LurLab-UCI/ShockBox/Docs/ShockBox_wiring.png

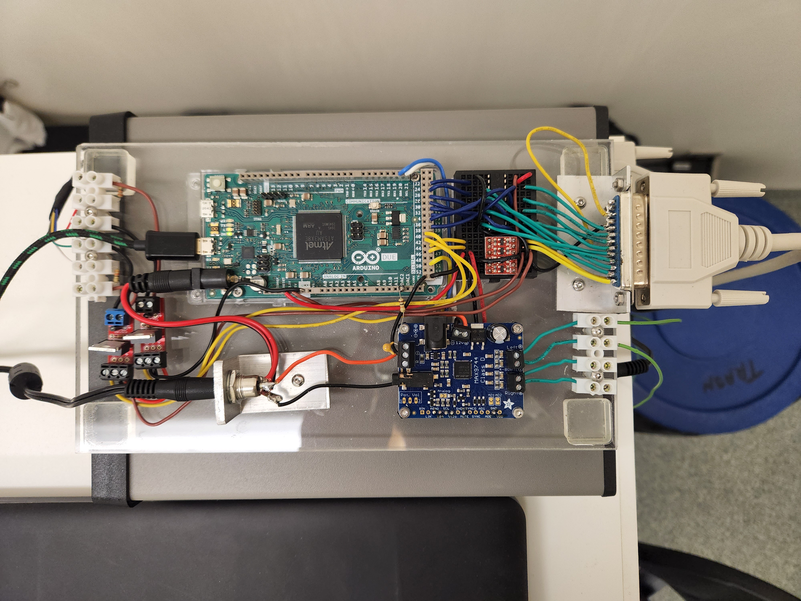
Docs/ShockBox_wiring.png
