LurLab-UCI/ShockBox/Docs/ShockBox_panel+shocker.jpg

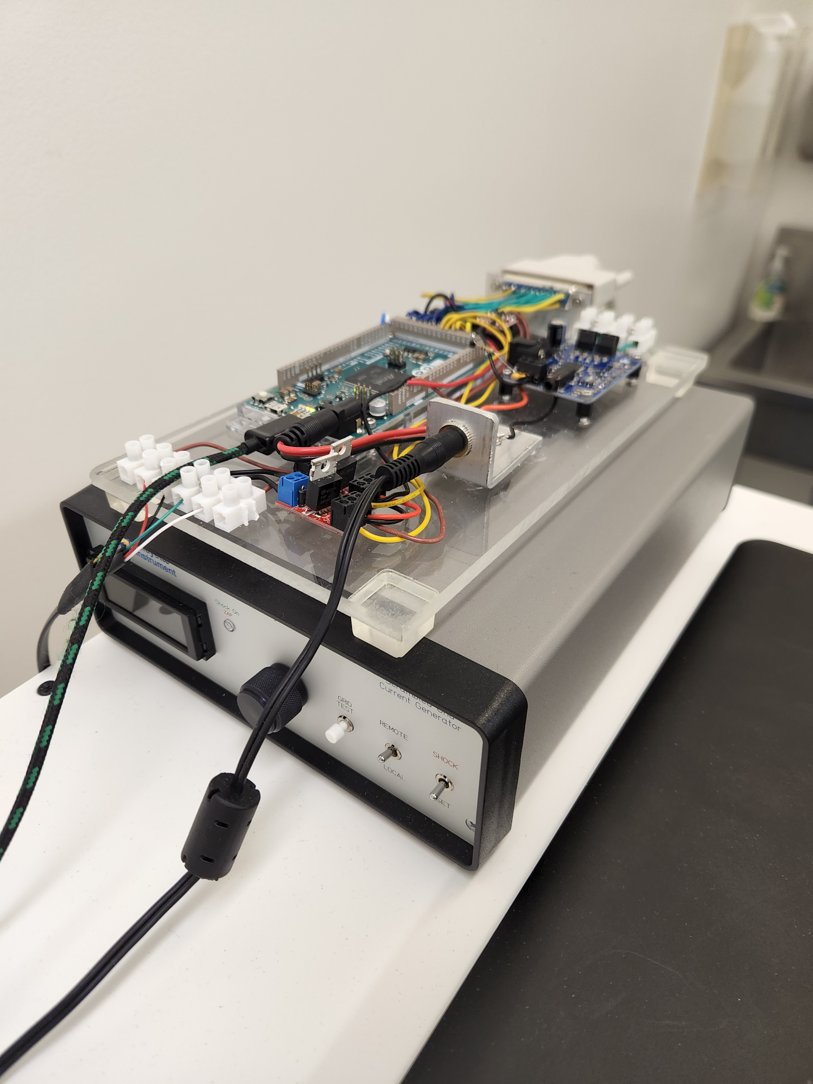
Docs/ShockBox_panel+shocker.jpg
