LurLab-UCI/ShockBox/README.md

# ShockBox

This is a hardware & software package for electric shock generation. It uses some OEM and some off the shelf parts. Experiemtns are run via a GUI developed as open source MATLAB code. 

See wiki page for build and operation details (https://github.com/LurLab-UCI/ShockBox/wiki).

Created by Mikko Oijala, Soo Bin Park, and Gyorgy Lur, PhD; Neuronal Signal Integration laboratory, UC Irvine;

This work was supported by the NIH - R01 MH123686
