LurLab-UCI/ShockBox/Docs/Shock_Box_circuit updated.pptx

Lur Lab Shock Box Circuit

12 V power
supply

+5 V

2

LS-241

19

DB-25 connector

1 Trigger

14 Test In

USB

+5 V

Arduino DUE

40 shock indicator

42 tone indicator

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
LED emitter

330

330

MOSFET Relay

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
LED emitter

MOSFET Relay

+

C

+

+5 V

+5 V

DAC0

SCL

SDA

47

45

Level Converter
BOB-12009

10 k

+12 V

21

20

+3.3 V

Audio Amp MAX 9744

SCL

SDA

Vi2c

Left Speaker

680 pF

Right Speaker

## Slide 2

Lur Lab Shock Box GUI

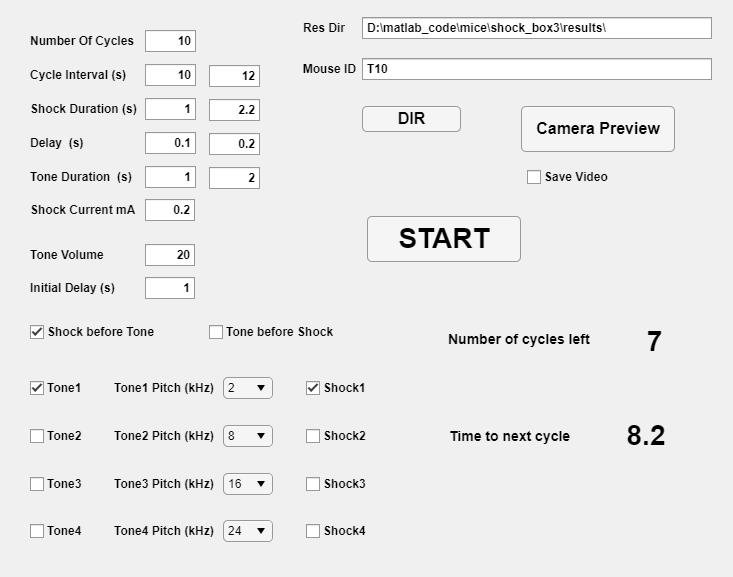
[picture p3: figure]

Each cycle consists of a tone followed or preceded by an optional shock , i.e. a cycle can contain a tone only, but a cycle with a shock is always accompanied with a tone either before or after.
There are 4 possible tones available with an optional shock associated with it.
If more than one tone is selected the tones and the corresponding shocks are played in random order the same number of times (the total number of cycles is adjusted accordingly).

Res Dir
Mouse ID
Camera Preview
Save Video
DIR
START

Number Of Cycles
Cycle Interval
Shock Duration
Delay
Tone Duration
Shock Current
Tone Volume
Initial Delay
Shock before Tone
Tone before Shock

Tone 1 2 3 4
Tone 1 2 3 4 Pitch
Shock 1 2 3 4

Displays the result directory
Input the mouse id here
Turn on the camera and preview
Save the video file of the session in the result directory
Select the result directory
Start the session
Total number of shock cycles in the session
Time from the start of a cycle the start of the next cycle
Duration of each shock
Delay from tone to shock or shock to tone for each cycle
Duration of each tone
The amount of shock current
The audio volume for tones
At the start the system waits this amount before proceeding
When selected each cycle is started with a shock followed by a tone
When selected each cycle is started with a tone followed by a shock

Select the tones used
Select the frequencies for the tones used
Select whether a shock is used with the tone
