LurLab-UCI/ShockBox/Docs/Shock_Box_circuit updated.png

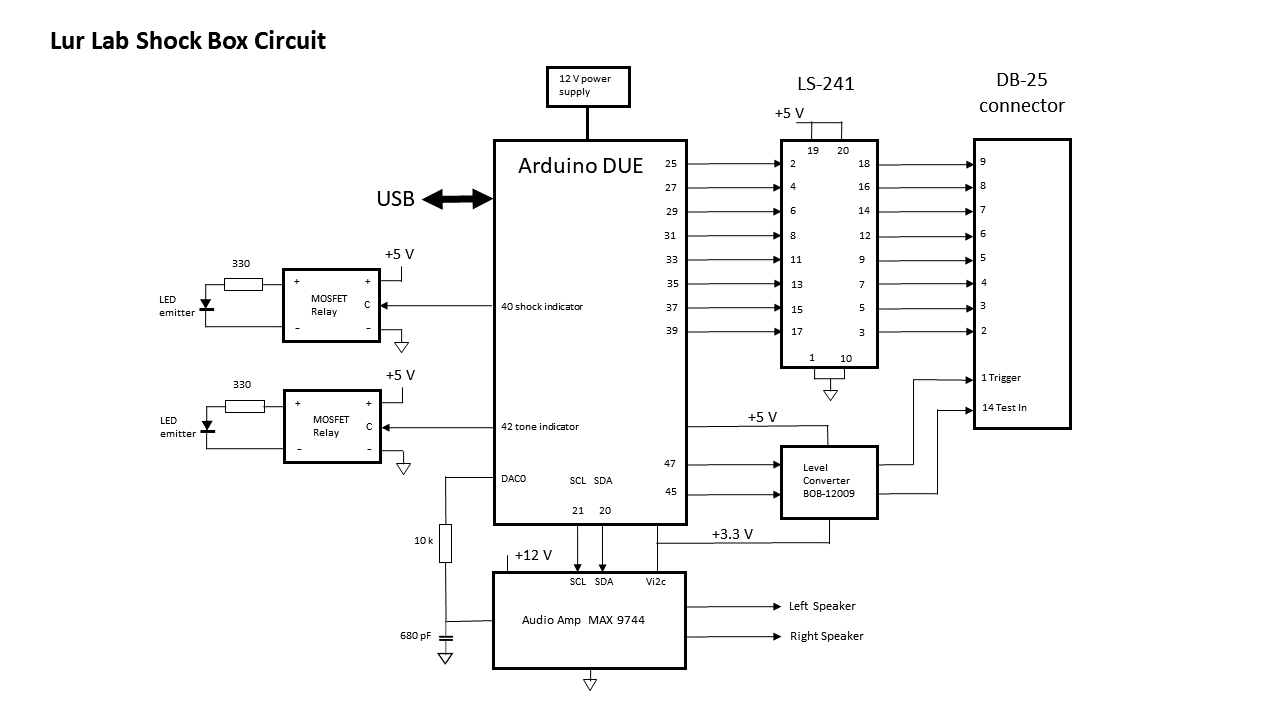
Docs/Shock_Box_circuit updated.png
