LurLab-UCI/ShockBox/Docs/Shock_Box_GUI.png

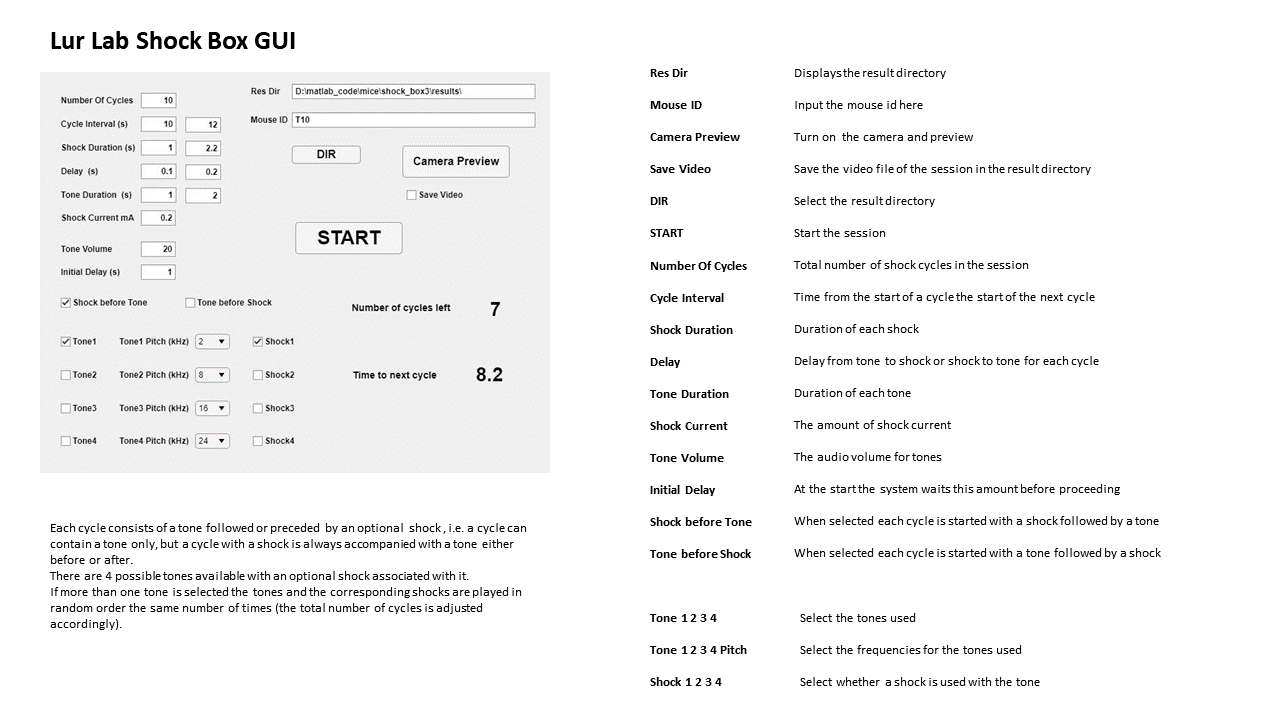
Docs/Shock_Box_GUI.png
