LurLab-UCI/ShockBox/Docs/ShockBox_camera.jpg

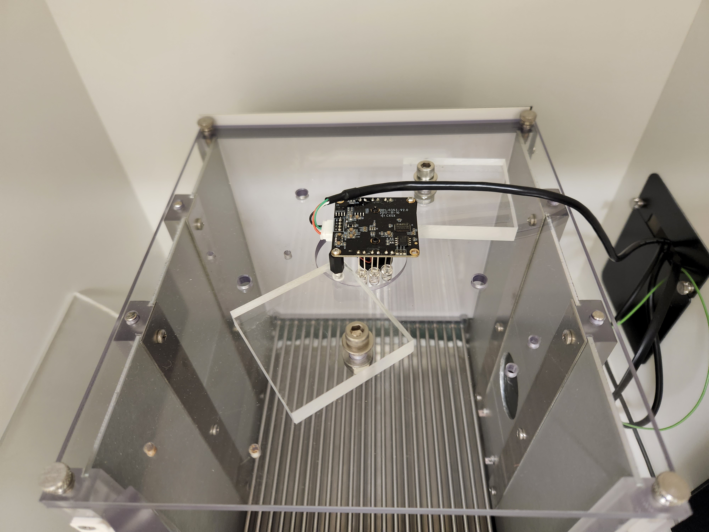
Docs/ShockBox_camera.jpg
