LurLab-UCI/ShockBox/Docs/ShockBox_fan.jpg

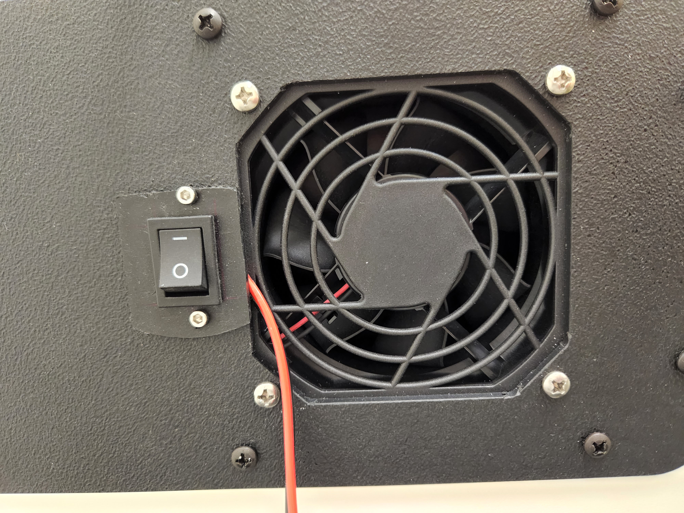
Docs/ShockBox_fan.jpg
