LurLab-UCI/ShockBox/Docs/ShockBox_output.PNG

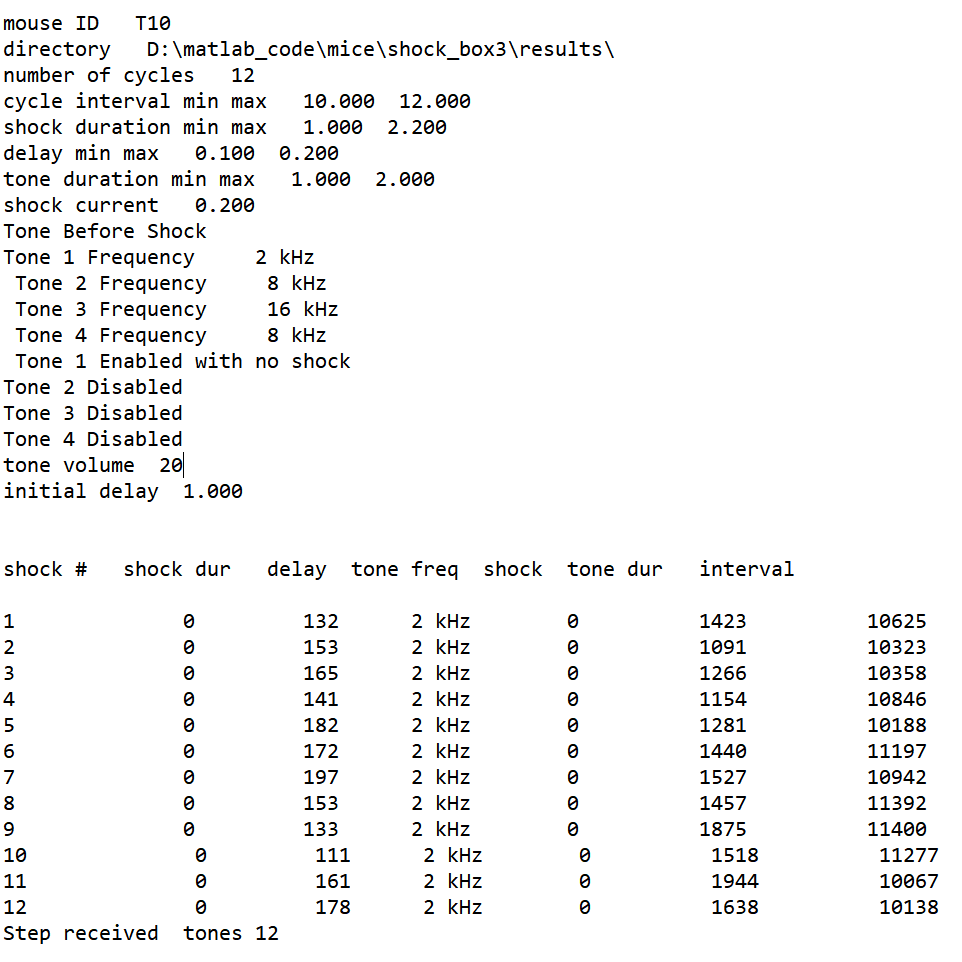
Docs/ShockBox_output.PNG
