LurLab-UCI/ShockBox/Docs/ShockBox_speaker_LEDs_back.jpg

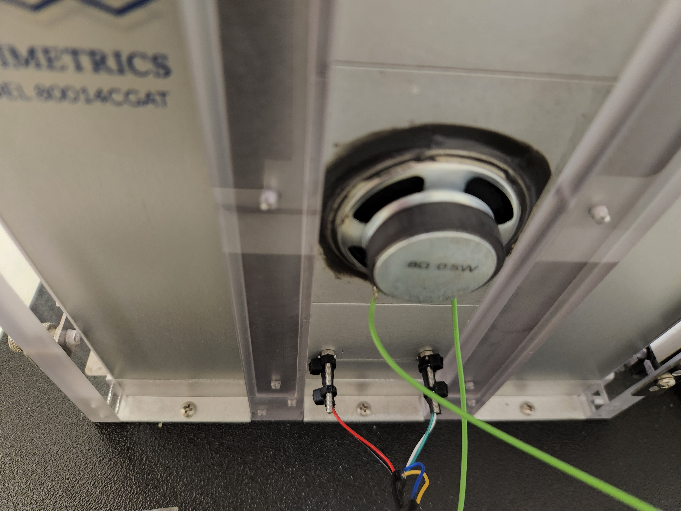
Docs/ShockBox_speaker_LEDs_back.jpg
