LurLab-UCI/ShockBox/Docs/ShockBox_speaker_LEDs_front.jpg

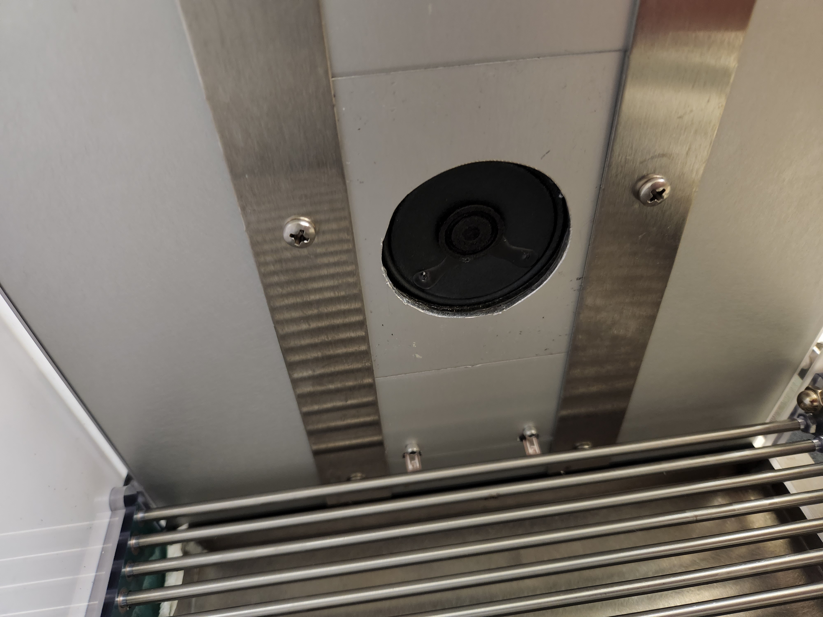
Docs/ShockBox_speaker_LEDs_front.jpg
