LurLab-UCI/ShockBox/Arduino/arduino_sbox14/Waveforms.h

#ifndef _Waveforms_h_
#define _Waveforms_h_

#define maxWaveform 4
#define maxSamplesNum 300

static int waveformsTable[maxWaveform][maxSamplesNum] = {
  // 0
  {
    0,0,0,0,0,0,0,0,0.0,
    0,0,0,0,0,0,0,0,0.0,
    0,0,0,0,0,0,0,0,0.0,
    0,0,0,0,0,0,0,0,0.0,
    0,0,0,0,0,0,0,0,0.0,
    0,0,0,0,0,0,0,0,0.0,
    0,0,0,0,0,0,0,0,0.0,
    0,0,0,0,0,0,0,0,0.0,
    0,0,0,0,0,0,0,0,0.0,
    0,0,0,0,0,0,0,0,0.0,
    0,0,0,0,0,0,0,0,0.0,
    0,0,0,0,0,0,0,0,0.0,
    0,0,0,0,0,0,0,0,0.0,
    0,0,0,0,0,0,0,0,0.0,
    0,0,0,0,0,0,0,0,0.0,
    0,0,0,0,0,0,0,0,0.0,
    0,0,0,0,0,0,0,0,0.0,
    0,0,0,0,0,0,0,0,0.0,
    0,0,0,0,0,0,0,0,0.0,
    0,0,0,0,0,0,0,0,0.0,
    0,0,0,0,0,0,0,0,0.0,
    0,0,0,0,0,0,0,0,0.0,
    0,0,0,0,0,0,0,0,0.0,
    0,0,0,0,0,0,0,0,0.0,
    0,0,0,0,0,0,0,0,0.0,
    0,0,0,0,0,0,0,0,0.0,
    0,0,0,0,0,0,0,0,0.0,
    0,0,0,0,0,0,0,0,0.0,
    0,0,0,0,0,0,0,0,0.0,
    0,0,0,0,0,0,0,0,0.0,
  }
  ,
  // Sin wave
  {
    2048,2304,2557,2801,3034,3251,3449,3626,3777,3901,
    3995,4059,4091,4091,4059,3995,3901,3777,3626,3449,
    3251,3034,2801,2557,2304,2048,1791,1538,1294,1061,
    844,646,469,318,194,100,36,4,4,36,
    100,194,318,469,646,844,1061,1294,1538,1791,
    2047,2304,2557,2801,3034,3251,3449,3626,3777,3901,
    3995,4059,4091,4091,4059,3995,3901,3777,3626,3449,
    3251,3034,2801,2557,2304,2048,1791,1538,1294,1061,
    844,646,469,318,194,100,36,4,4,36,
    100,194,318,469,646,844,1061,1294,1538,1791,
    2047,2304,2557,2801,3034,3251,3449,3626,3777,3901,
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
    1962,2310,3394,1786,3942,522,3780,2822,1869,593,
    79,1584,74,2043,570,3660,4095,849,3196,240,
    2229,514,2784,704,266,2419,625,1595,871,0,
    3509,3912,1908,1584,1580,1247,3618,4095,927,2885,
  }
,
  // Square wave
  {
  }

};

#endif
 
